CMU-Robotics-Club/Red-Robot-2023/PCB-Files/RedRobotBreakout.kicad_pcb

## KiCad design PCB-Files/RedRobotBreakout.kicad_pcb (2025-08-05)

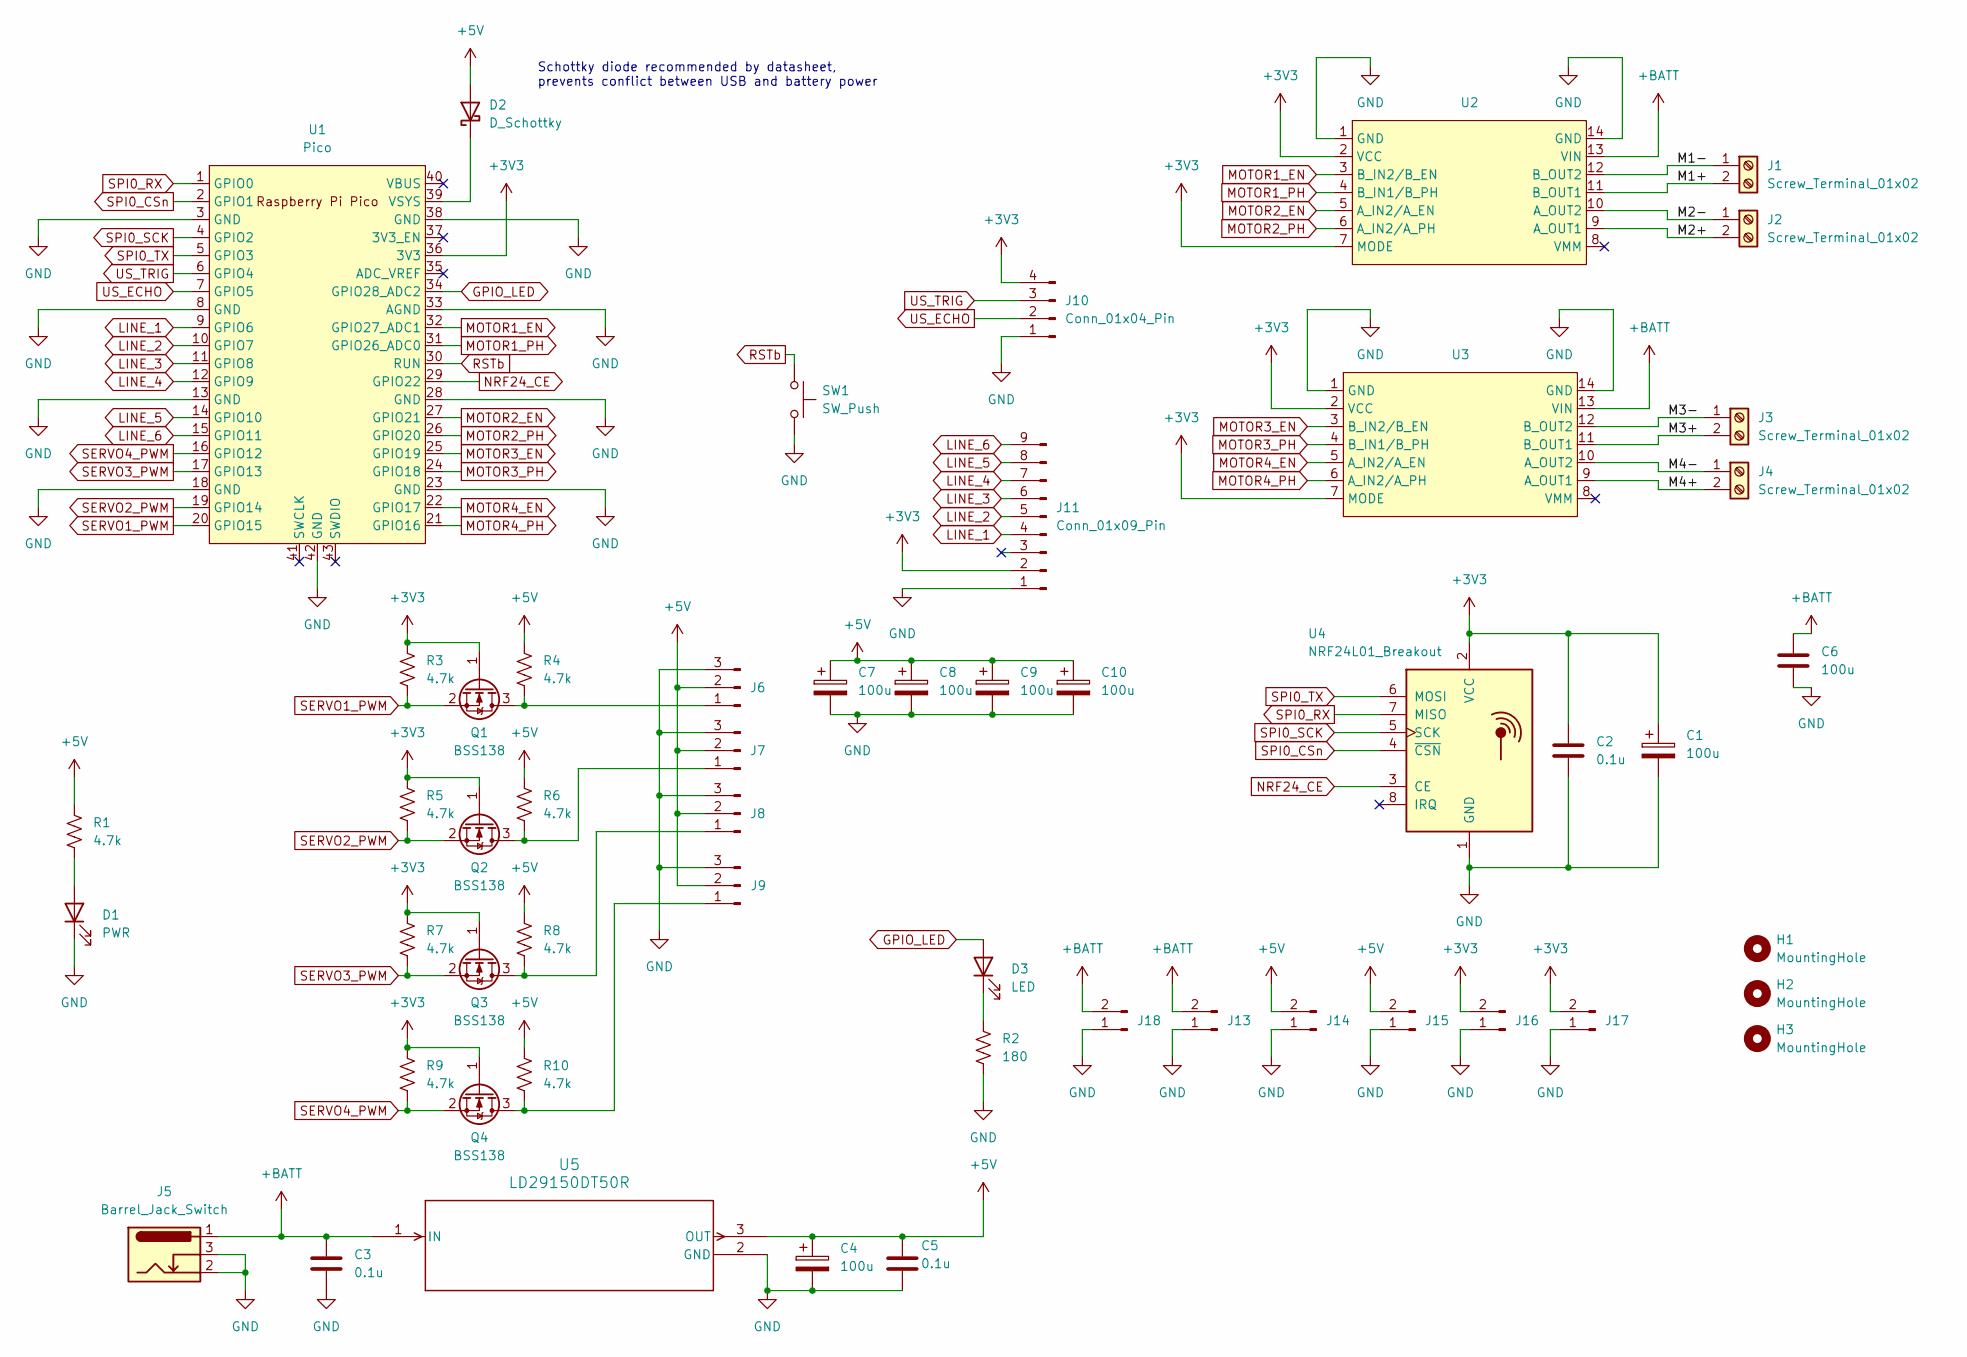
[picture p2: schematic RedRobotBreakout.kicad_sch]

Parts:
C1, C4, C6, C7, C8, C9, C10: 100u; CP_Elec_5x5.4; JLC P/N C22387981
C2, C3, C5: 0.1u; C_1206_3216Metric_Pad1.33x1.80mm_HandSolder; JLC P/N C24497
D1: PWR; LED_0805_2012Metric_Pad1.15x1.40mm_HandSolder; JLC P/N C2297
D2: D_Schottky; SOT-23; JLC P/N C22466368
D3: LED; LED_0603_1608Metric_Pad1.05x0.95mm_HandSolder; JLC P/N C2286
H1, H2, H3: MountingHole; MountingHole_3.2mm_M3_Pad_Via
J1, J2, J3, J4: Screw_Terminal_01x02; ScrewTerminalP3.5mm; JLC P/N C695629
J5: Barrel_Jack_Switch; BarrelJack_Horizontal; JLC P/N C136744
J6, J7, J8, J9: Conn_01x03_Pin; PinHeader_1x03_P2.54mm_Vertical; JLC P/N C6332196
J10: Conn_01x04_Pin; PinHeader_1x04_P2.54mm_Vertical; JLC P/N C6332197
J11: Conn_01x09_Pin; PinHeader_1x09_P2.54mm_Vertical; JLC P/N C492408
J13, J14, J15, J16, J17, J18: Conn_01x02_Pin; PinHeader_1x02_P2.54mm_Vertical; JLC P/N C2905434
Q1, Q2, Q3, Q4: BSS138; SOT-23; JLC P/N C112239
R1, R3, R4, R5, R6, R7, R8, R9, R10: 4.7k; R_1206_3216Metric_Pad1.30x1.75mm_HandSolder; JLC P/N C17936
R2: 180; R_1206_3216Metric_Pad1.30x1.75mm_HandSolder; JLC P/N C17924
SW1: SW_Push; SW_Push_1P1T_XKB_TS-1187A; JLC P/N C318884
U1: Pico; RPi_Pico_SMD_TH
U2, U3: DRV8835
U4: NRF24L01_Breakout; nRF24L01_Breakout; JLC P/N C92271
U5: LD29150DT50R; TO-252-2; JLC P/N C157411

Connections:
+3V3: C1.1, C2.1, J10.4, J11.2, J16.2, J17.2, Q1.1 (G), Q2.1 (G), Q3.1 (G), Q4.1 (G), R3.1, R5.1, R7.1, R9.1, U1.36 (3V3), U2.2 (VCC), U2.7 (MODE), U3.2 (VCC), U3.7 (MODE), U4.2 (VCC)
+5V: C4.1, C5.1, C7.1, C8.1, C9.1, C10.1, D2.2 (A), J6.2, J7.2, J8.2, J9.2, J14.2, J15.2, R1.1, R4.1, R6.1, R8.1, R10.1, U5.3 (OUT)
+BATT: C3.1, C6.1, J5.1, J13.2, J18.2, U2.13 (VIN), U3.13 (VIN), U5.1 (IN)
/M1+: J1.2, U2.11 (B_OUT1)
/M1-: J1.1, U2.12 (B_OUT2)
/M2+: J2.2, U2.9 (A_OUT1)
/M2-: J2.1, U2.10 (A_OUT2)
/M3+: J3.2, U3.11 (B_OUT1)
/M3-: J3.1, U3.12 (B_OUT2)
/M4+: J4.2, U3.9 (A_OUT1)
/M4-: J4.1, U3.10 (A_OUT2)
GND: C1.2, C2.2, C3.2, C4.2, C5.2, C6.2, C7.2, C8.2, C9.2, C10.2, D1.1 (K), J5.2, J5.3, J6.3, J7.3, J8.3, J9.3, J10.1, J11.1, J13.1, J14.1, J15.1, J16.1, J17.1, J18.1, R2.2, SW1.2, U1.3 (GND), U1.8 (GND), U1.13 (GND), U1.18 (GND), U1.23 (GND), U1.28 (GND), U1.33 (AGND), U1.38 (GND), U1.42 (GND), U2.1 (GND), U2.14 (GND), U3.1 (GND), U3.14 (GND), U4.1 (GND), U5.2 (GND)
GPIO_LED: D3.2 (A), U1.34 (GPIO28_ADC2)
LINE_1: J11.4, U1.9 (GPIO6)
LINE_2: J11.5, U1.10 (GPIO7)
LINE_3: J11.6, U1.11 (GPIO8)
LINE_4: J11.7, U1.12 (GPIO9)
LINE_5: J11.8, U1.14 (GPIO10)
LINE_6: J11.9, U1.15 (GPIO11)
MOTOR1_EN: U1.32 (GPIO27_ADC1), U2.3 (B_IN2/B_EN)
MOTOR1_PH: U1.31 (GPIO26_ADC0), U2.4 (B_IN1/B_PH)
MOTOR2_EN: U1.27 (GPIO21), U2.5 (A_IN2/A_EN)
MOTOR2_PH: U1.26 (GPIO20), U2.6 (A_IN2/A_PH)
MOTOR3_EN: U1.25 (GPIO19), U3.3 (B_IN2/B_EN)
MOTOR3_PH: U1.24 (GPIO18), U3.4 (B_IN1/B_PH)
MOTOR4_EN: U1.22 (GPIO17), U3.5 (A_IN2/A_EN)
MOTOR4_PH: U1.21 (GPIO16), U3.6 (A_IN2/A_PH)
NRF24_CE: U1.29 (GPIO22), U4.3 (CE)
unnamed: D1.2 (A), R1.2
unnamed: D2.1 (K), U1.39 (VSYS)
unnamed: D3.1 (K), R2.1
unnamed: J6.1, Q1.3 (D), R4.2
unnamed: J7.1, Q2.3 (D), R6.2
unnamed: J8.1, Q3.3 (D), R8.2
unnamed: J9.1, Q4.3 (D), R10.2
RSTb: SW1.1, U1.30 (RUN)
SERVO1_PWM: Q1.2 (S), R3.2, U1.20 (GPIO15)
SERVO2_PWM: Q2.2 (S), R5.2, U1.19 (GPIO14)
SERVO3_PWM: Q3.2 (S), R7.2, U1.17 (GPIO13)
SERVO4_PWM: Q4.2 (S), R9.2, U1.16 (GPIO12)
SPI0_CSn: U1.2 (GPIO1), U4.4 (~CSN)
SPI0_RX: U1.1 (GPIO0), U4.7 (MISO)
SPI0_SCK: U1.4 (GPIO2), U4.5 (SCK)
SPI0_TX: U1.5 (GPIO3), U4.6 (MOSI)
US_ECHO: J10.2, U1.7 (GPIO5)
US_TRIG: J10.3, U1.6 (GPIO4)

Notes on the sheet:
Schottky diode recommended by datasheet, prevents conflict between USB and battery power

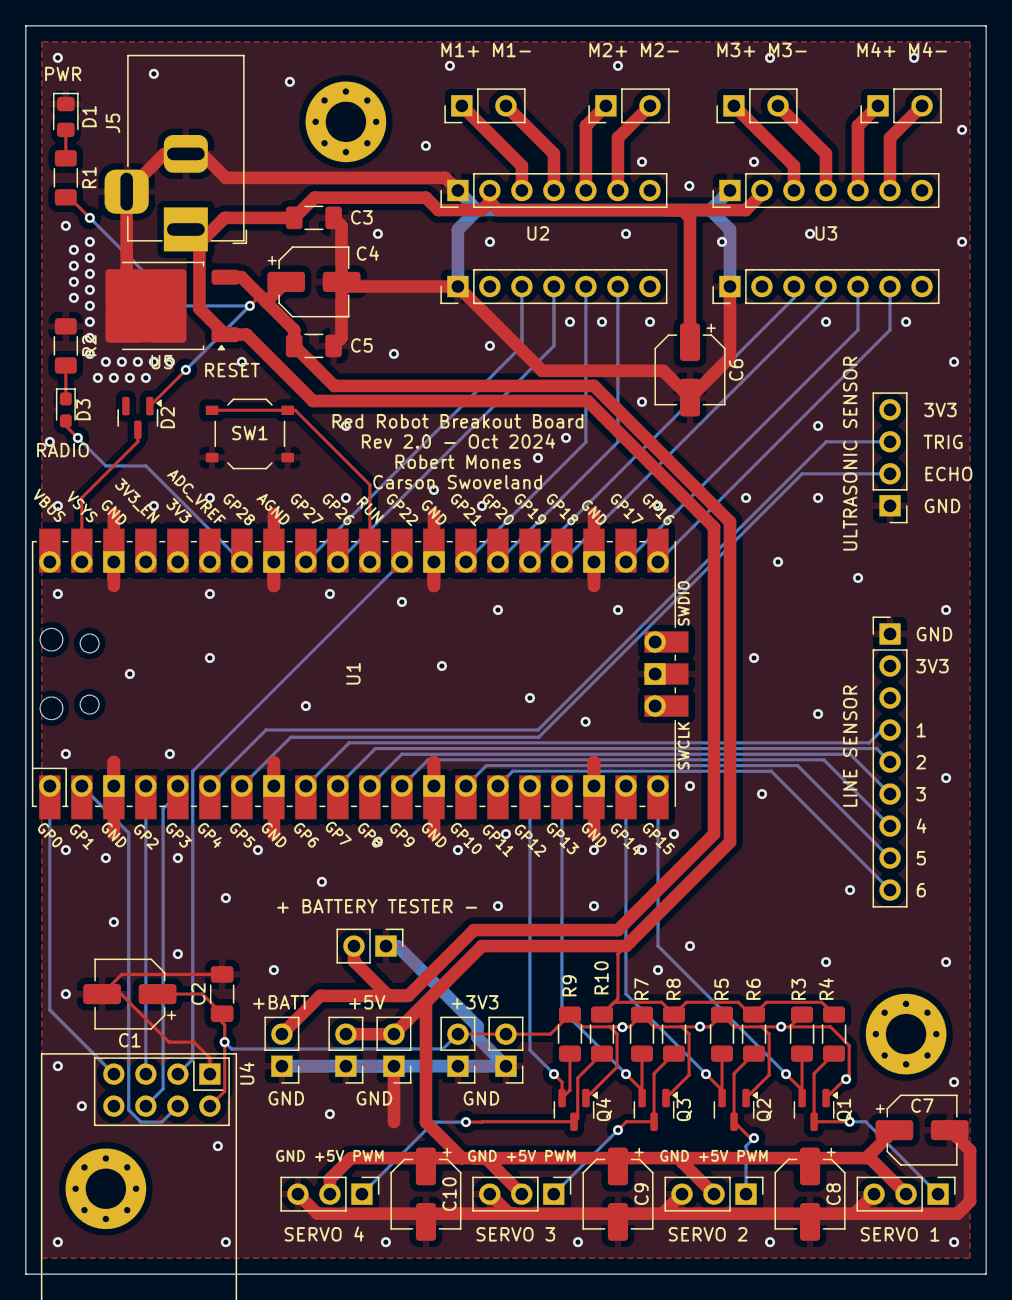
[picture p3: board RedRobotBreakout.kicad_pcb from above]

Board: 4 copper layers, 76.2 x 99.1 mm, 53 parts (0 on the bottom side), 46 nets.
