CMU-Robotics-Club/Red-Robot-2023/(commit log)

2024-11-01 Fixed Update for 2024
    This reverts part of commit b41f08040d1129fef7a20f06438e1e1cbf41e864.
    [controller_hid.py]
2025-08-05 added PCB files from 2024, have not been edited yet
    [RedRobotBreakout-B_Cu.gbl, RedRobotBreakout-B_Mask.gbs, RedRobotBreakout-B_Paste.gbp, RedRobotBreakout-B_Silkscreen.gbo, RedRobotBreakout-Edge_Cuts.gm1, RedRobotBreakout-F_Cu.gtl, RedRobotBreakout-F_Mask.gts, RedRobotBreakout-F_Paste.gtp]
2025-08-20 removed duplicate pcb files
    [RedRobotBreakout-B_Cu.gbl, RedRobotBreakout-B_Mask.gbs, RedRobotBreakout-B_Paste.gbp, RedRobotBreakout-B_Silkscreen.gbo, RedRobotBreakout-Edge_Cuts.gm1, RedRobotBreakout-F_Cu.gtl, RedRobotBreakout-F_Mask.gts, RedRobotBreakout-F_Paste.gtp]
2025-11-01 Fixed number of teams
    [Arduino-Starter.ino]
